matheusmorais12/PI-Regulateur-de-Tension/(list of files, drawings)

Other design files:
Amplificador.pdsprj
Passabaixa.pdsprj
SavReg.pdsprj
